Morn-Thuta/EcoWaves-TrayTrack-YTB2026-Best-Innovation-/firmware/images/README.md

# Hardware build photos

Drop the build photos here with these **exact filenames** so the READMEs render them:

| Filename | Photo it should be |
|---|---|
| `01-esp32-dev-board.png` | The ESP32-WROOM development board (black PCB, micro-USB) |
| `02-load-cell-bracket.jpg` | A single 50 kg load cell in its 3D-printed corner bracket (red/black/white wires) |
| `03-load-cell-platform-wiring.jpg` | Underside of the platform — the four load cells wired together at the corners |
| `04-assembled-platform.jpg` | The assembled plywood platform wired to the ESP32 + HX711 |
| `05-live-test-egg-tray.jpg` | The tray of eggs sitting on the platform (live test) |
| `06-load-cell-3wire.jpg` | Close-up of a single bare 50 kg load cell showing the red/black/white 3-wire lead |

`.jpg`, `.jpeg`, and `.png` all work — just keep the base name the same as above, or the README image links won't resolve. `01`–`05` order matches the gallery in [`../README.md`](../README.md).
