Morn-Thuta/EcoWaves-TrayTrack-YTB2026-Best-Innovation-/(commit log)

2026-04-02 feat: initial MVP scaffolding for tray weight monitoring system
    Complete project structure: Next.js web app (Chef Dashboard + Management Screen),
    Supabase schema with Edge Function for sensor ingestion, ESP32 firmware with
    offline buffering, and 90-day mock data seed script.
2026-07-19 docs: add project READMEs for every part (software + hardware)
    Add a flagship root README and per-directory documentation so the repo
    tells the full TrayTrack story — from load cell to live dashboard.
    - README.md: overview, architecture, monorepo map, stack, quick start,
    impact model, and an honest roadmap section
    - firmware/README.md: hardware BOM, Wheatstone-bridge wiring, pinout,
    on-device calibration procedure, firmware module breakdown, offline
    buffering, and PlatformIO flash instructions
    - supabase/README.md: schema + relationships, the tray_dashboard_view,
    business-logic functions, RLS model, Realtime, and the ingest-reading
    Edge Function
    - web/README.md: replace create-n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
2026-07-19 docs: add hardware build photo gallery and tutorial credit
    - firmware/README.md: add a "The build" photo gallery (ESP32 board,
    load-cell bracket, Wheatstone-bridge wiring, assembled platform,
    live egg-tray test) and a Credits & References section crediting the
    load-cell build tutorial the hardware was based on
    - README.md: add a hero photo of the live sensor platform
    - firmware/images/README.md: document the expected photo filenames
    Claude-Session: https://claude.ai/code/session_01FDLUz4ZHdGRhrCVrg4ZfMJ
2026-07-19 docs: add bare load-cell close-up to firmware wiring section
    Illustrate the red/black/white 3-wire lead alongside the Wheatstone-bridge
    wiring instructions; document the new image filename.
    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
2026-07-19 docs: fix uploaded image filenames to match README references
    Uploaded photos had doubled extensions (.jpg.jpg / .jpg.png); rename to
    the canonical names the READMEs reference and point the ESP32 board image
    at its true .png extension.
    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
